MadeInFck/autonomous-robot/hardware/pico_carrier.kicad_sch

## KiCad design hardware/pico_carrier.kicad_sch (2026-02-14)

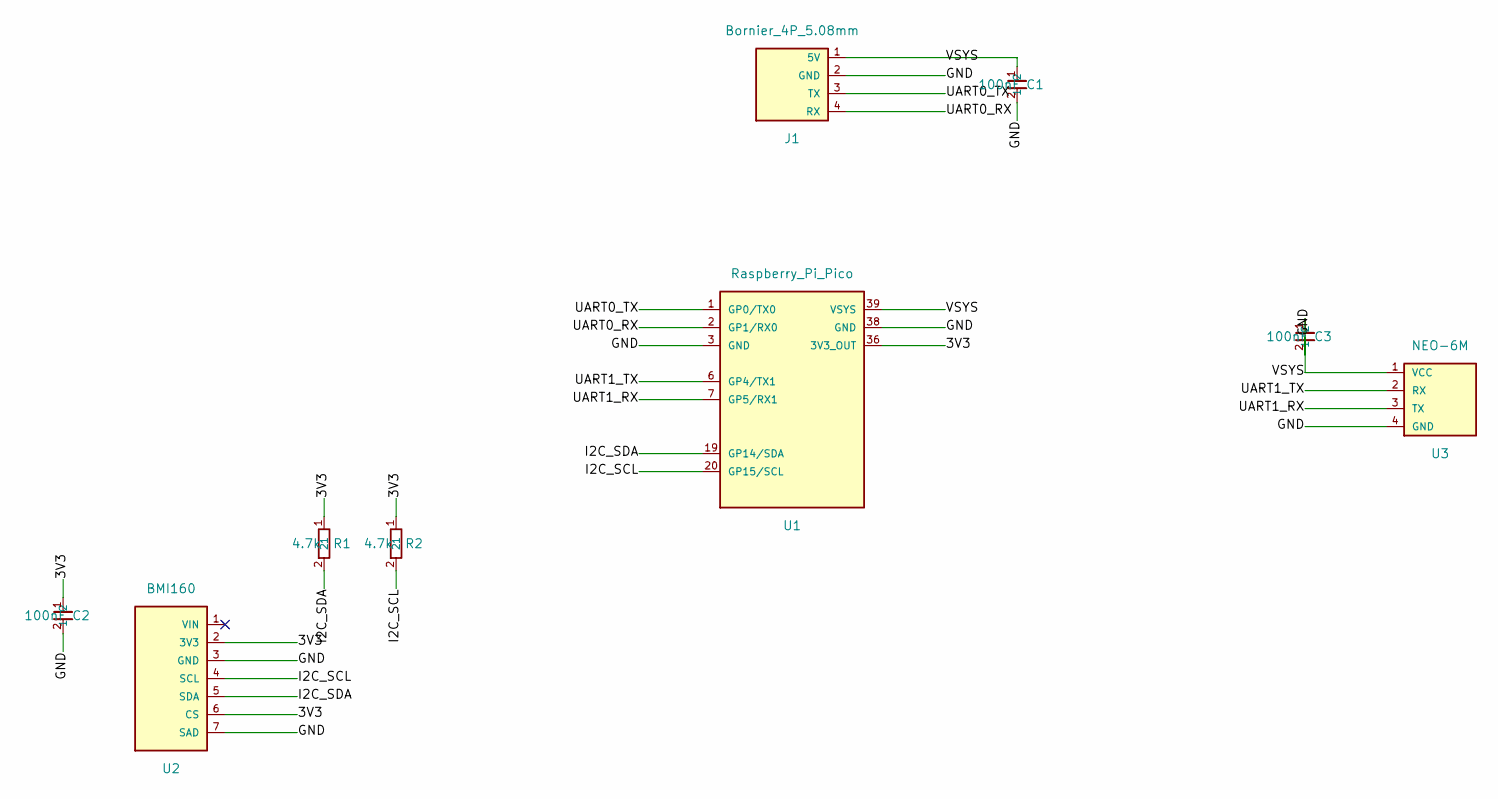
[picture p1: schematic pico_carrier.kicad_sch]

Parts:
C1, C2, C3: 100nF; C_0805_2012Metric
J1: Bornier_4P_5.08mm; TerminalBlock_bornier-4_P5.08mm
R1, R2: 4.7k; R_0805_2012Metric
U1: Raspberry_Pi_Pico; PinHeader_2x20_P2.54mm_Vertical
U2: BMI160; PinHeader_1x07_P2.54mm_Vertical
U3: NEO-6M; PinHeader_1x04_P2.54mm_Vertical

Connections:
3V3: C2.1, R1.1, R2.1, U1.36 (3V3_OUT), U2.2 (3V3), U2.6 (CS)
GND: C1.1, C1.2, C2.2, C3.1, C3.2, J1.1 (5V), J1.2 (GND), U1.3 (GND), U1.38 (GND), U1.39 (VSYS), U2.3 (GND), U2.7 (SAD), U3.1 (VCC), U3.4 (GND)
I2C_SCL: R2.2, U1.20 (GP15/SCL), U2.4 (SCL)
I2C_SDA: R1.2, U1.19 (GP14/SDA), U2.5 (SDA)
UART0_RX: J1.4 (RX), U1.2 (GP1/RX0)
UART0_TX: J1.3 (TX), U1.1 (GP0/TX0)
UART1_RX: U1.7 (GP5/RX1), U3.3 (TX)
UART1_TX: U1.6 (GP4/TX1), U3.2 (RX)
