MadeInFck/autonomous-robot/pi5/tests/test_uart_receiver.py

"""
Tests for FrameReader (state machine) and UART decoding
"""

import sys
import os
import pytest

sys.path.insert(0, os.path.join(os.path.dirname(__file__), '..', 'sensors'))
sys.path.insert(0, os.path.join(os.path.dirname(__file__), '..', '..', 'pico', 'lib'))

import json

from uart_receiver import (
    FrameReader, parse_payload, calc_crc8, STX, ETX, PAYLOAD_LEN,
    ImuCalibrationLatch, frame_to_sensor_data,
)
from protocole import (
    build_frame, FLAG_IMU_BNO085, FLAG_IMU_HEADING, convert_angle_to_centideg,
    convert_accuracy_to_raw, convert_course_to_raw,
)


def make_valid_frame(**kwargs):
    """Helper: build a valid frame with default values"""
    defaults = dict(
        seq=1, acc_x=0, acc_y=0, acc_z=981,
        gyr_x=0, gyr_y=0, gyr_z=0,
        latitude=48856600, longitude=2352200,
        altitude=352, vitesse=0, cap=0,
        satellites=8, fix_quality=1
    )
    defaults.update(kwargs)
    return build_frame(**defaults)


# ===== FrameReader: valid frames =====

class TestFrameReaderValid:
    def test_single_valid_frame(self):
        reader = FrameReader()
        frame = make_valid_frame()
        reader.feed(frame)

        result = reader.get_frame()
        assert result is not None
        assert result['crc_ok'] is True
        assert result['seq'] == 1

    def test_multiple_frames(self):
        reader = FrameReader()
        for i in range(5):
            frame = make_valid_frame(seq=i)
            reader.feed(frame)

        for i in range(5):
            result = reader.get_frame()
            assert result is not None
            assert result['seq'] == i

        assert reader.get_frame() is None

    def test_frame_data_decoded(self):
        reader = FrameReader()
        frame = make_valid_frame(
            seq=42, acc_x=100, acc_y=-200, acc_z=981,
            satellites=12, fix_quality=2
        )
        reader.feed(frame)

        result = reader.get_frame()
        assert result['seq'] == 42
        assert abs(result['acc_x'] - 0.1) < 0.001
        assert abs(result['acc_y'] - (-0.2)) < 0.001
        assert result['satellites'] == 12
        assert result['fix_quality'] == 2

    def test_byte_by_byte(self):
        """Byte-by-byte feeding (as in serial reception)"""
        reader = FrameReader()
        frame = make_valid_frame()

        for byte in frame:
            reader.feed(bytes([byte]))

        result = reader.get_frame()
        assert result is not None
        assert result['crc_ok'] is True


# ===== FrameReader: errors =====

class TestFrameReaderErrors:
    def test_bad_crc(self):
        reader = FrameReader()
        frame = bytearray(make_valid_frame())
        frame[-2] ^= 0xFF  # Corrupt the CRC
        reader.feed(bytes(frame))

        assert reader.get_frame() is None
        error = reader.get_error()
        assert error is not None
        assert "CRC" in error

    def test_missing_etx(self):
        reader = FrameReader()
        frame = bytearray(make_valid_frame())
        frame[-1] = 0x00  # Replace ETX with something else
        reader.feed(bytes(frame))

        assert reader.get_frame() is None
        error = reader.get_error()
        assert error is not None
        assert "ETX" in error

    def test_garbage_before_frame(self):
        """Random bytes before STX should be ignored"""
        reader = FrameReader()
        garbage = bytes([0x55, 0xAA, 0xFF, 0x00, 0x42])
        frame = make_valid_frame(seq=99)
        reader.feed(garbage + frame)

        result = reader.get_frame()
        assert result is not None
        assert result['seq'] == 99

    def test_garbage_between_frames(self):
        """Garbage between two valid frames"""
        reader = FrameReader()
        f1 = make_valid_frame(seq=1)
        f2 = make_valid_frame(seq=2)
        garbage = bytes([0xFF, 0xAA, 0x55])

        reader.feed(f1 + garbage + f2)

        r1 = reader.get_frame()
        assert r1 is not None
        assert r1['seq'] == 1

        r2 = reader.get_frame()
        assert r2 is not None
        assert r2['seq'] == 2

    def test_partial_frame_then_complete(self):
        """Partial frame followed by a complete frame"""
        reader = FrameReader()
        frame = make_valid_frame(seq=77)

        # Send the first half
        reader.feed(frame[:17])
        assert reader.get_frame() is None

        # Send the rest
        reader.feed(frame[17:])
        result = reader.get_frame()
        assert result is not None
        assert result['seq'] == 77

    def test_zero_length(self):
        """Length 0 must be rejected"""
        reader = FrameReader()
        reader.feed(bytes([STX, 0x00]))
        error = reader.get_error()
        assert error is not None
        assert "invalide" in error.lower()

    def test_corrupted_payload(self):
        """Corrupted payload but CRC preserved = CRC mismatch"""
        reader = FrameReader()
        frame = bytearray(make_valid_frame())
        frame[10] ^= 0xFF  # Corrupt a payload byte
        reader.feed(bytes(frame))

        assert reader.get_frame() is None
        assert reader.get_error() is not None


# ===== parse_payload =====

class TestParsePayload:
    def test_payload_size(self):
        """The payload must be exactly 30 bytes"""
        import struct
        payload = struct.pack('<HhhhhhhllhHHBB',
                              0, 0, 0, 0, 0, 0, 0, 0, 0, 0, 0, 0, 0, 0)
        assert len(payload) == PAYLOAD_LEN

    def test_speed_conversion(self):
        """Speed cm/s -> m/s and km/h"""
        import struct
        # 500 cm/s = 5.0 m/s = 18.0 km/h
        payload = struct.pack('<HhhhhhhllhHHBB',
                              0, 0, 0, 0, 0, 0, 0, 0, 0, 0, 500, 0, 0, 0)
        data = parse_payload(payload)
        assert abs(data['vitesse_ms'] - 5.0) < 0.01
        assert abs(data['vitesse_kmh'] - 18.0) < 0.01

    def test_heading_conversion(self):
        """Heading 0.01deg -> deg"""
        import struct
        # 27050 = 270.50 deg
        payload = struct.pack('<HhhhhhhllhHHBB',
                              0, 0, 0, 0, 0, 0, 0, 0, 0, 0, 0, 27050, 0, 0)
        data = parse_payload(payload)
        assert abs(data['cap'] - 270.5) < 0.01


# ===== Sequence checking =====

class TestSequenceCheck:
    def test_sequence_wrap_around(self):
        """Sequence must wrap from 65535 to 0"""
        frame_max = make_valid_frame(seq=65535)
        frame_zero = make_valid_frame(seq=0)

        reader = FrameReader()
        reader.feed(frame_max)
        reader.feed(frame_zero)

        r1 = reader.get_frame()
        r2 = reader.get_frame()
        assert r1['seq'] == 65535
        assert r2['seq'] == 0


# ===== Resync after line noise =====

class TestResync:
    def test_bogus_length_does_not_swallow_next_frame(self):
        """An STX in the noise followed by a large LEN used to eat 255 bytes."""
        reader = FrameReader()
        reader.feed(bytes([STX, 0xFF]) + make_valid_frame(seq=5))
        result = reader.get_frame()
        assert result is not None and result['seq'] == 5


# ===== BNO085 frames =====

def make_bno_frame(pitch=0.0, roll=0.0, accuracy=5.0, yaw=0.0, fix=1,
                   course=0.0, live=True):
    return make_valid_frame(
        acc_x=convert_angle_to_centideg(pitch),
        acc_y=convert_angle_to_centideg(roll),
        acc_z=0, gyr_x=convert_course_to_raw(course), gyr_y=0,
        gyr_z=convert_accuracy_to_raw(accuracy),
        cap=int(yaw * 100),
        fix_quality=fix | FLAG_IMU_BNO085 | (FLAG_IMU_HEADING if live else 0),
    )


def decode(frame_bytes):
    reader = FrameReader()
    reader.feed(frame_bytes)
    return reader.get_frame()


@pytest.fixture
def latch(tmp_path):
    return ImuCalibrationLatch(path=str(tmp_path / 'cal.json'))


class TestBno085Decoding:
    @pytest.mark.parametrize('pitch, roll', [
        (0.0, 0.0), (12.34, -5.5), (-45.0, 170.0), (89.9, -179.99),
    ])
    def test_orientation_full_range(self, pitch, roll, latch):
        """Pitch/roll beyond +/-32.7 deg used to overflow the int16 field."""
        data = frame_to_sensor_data(decode(make_bno_frame(pitch, roll)), latch)
        assert data.imu_type == 'BNO085'
        assert abs(data.pitch - pitch) < 0.011
        assert abs(data.roll - roll) < 0.011

    def test_orientation_clamped_not_wrapped(self):
        assert convert_angle_to_centideg(400.0) == 18000
        assert convert_angle_to_centideg(-400.0) == -18000

    def test_accuracy_and_fields(self, latch):
        data = frame_to_sensor_data(decode(make_bno_frame(accuracy=7.5, yaw=271.25)), latch)
        assert abs(data.heading_accuracy_deg - 7.5) < 0.01
        assert abs(data.heading - 271.25) < 0.01
        assert data.imu_calibrated is True
        # BMI160 fields carry nothing with a BNO085
        assert data.acc_x == data.acc_y == data.gyr_z == 0.0

    def test_accuracy_capped(self):
        assert convert_accuracy_to_raw(500.0) == 1800

    def test_bmi160_frame_keeps_raw_imu(self, latch):
        frame = decode(make_valid_frame(acc_x=120, acc_z=981, gyr_z=-35))
        data = frame_to_sensor_data(frame, latch)
        assert data.imu_type == 'BMI160'
        assert abs(data.acc_x - 0.12) < 1e-9
        assert abs(data.gyr_z + 3.5) < 1e-9
        assert data.imu_calibrated is False
        assert data.pitch == data.roll == 0.0


class TestHeading:
    def test_gps_course_travels_beside_the_compass(self, latch):
        data = frame_to_sensor_data(decode(make_bno_frame(yaw=95.0, course=12.3)), latch)
        assert data.heading == pytest.approx(95.0)
        assert data.course == pytest.approx(12.3)
        assert data.imu_heading_valid is True

    def test_mounting_offset_applied_once_and_wrapped(self, latch):
        frame = decode(make_bno_frame(yaw=350.0))
        assert frame_to_sensor_data(frame, latch, 20.0).heading == pytest.approx(10.0)
        assert frame_to_sensor_data(frame, latch, -20.0).heading == pytest.approx(330.0)

    def test_silent_compass_falls_back_to_gps_course(self, latch, tmp_path):
        """No BNO085 report: the heading is the GPS course, never trusted as a
        compass, and a saved calibration is not forgotten for so little."""
        assert latch.update(5.0) is True
        frame = decode(make_bno_frame(yaw=95.0, course=12.3, accuracy=180.0, live=False))
        data = frame_to_sensor_data(frame, latch, heading_offset_deg=30.0)
        assert data.heading == pytest.approx(12.3)
        assert data.imu_calibrated is False and data.imu_heading_valid is False
        assert json.loads((tmp_path / 'cal.json').read_text())['calibrated'] is True

    def test_bmi160_course_is_the_cap(self, latch):
        data = frame_to_sensor_data(decode(make_valid_frame(cap=4520)), latch, 30.0)
        assert data.heading == data.course == pytest.approx(45.2)

    def test_course_encoding(self):
        assert convert_course_to_raw(359.95) == 3599
        assert convert_course_to_raw(360.0) == 0


class TestImuCalibrationLatch:
    def test_good_accuracy_calibrates_and_persists(self, latch, tmp_path):
        assert latch.update(25.0) is False
        assert latch.update(8.0) is True
        assert json.loads((tmp_path / 'cal.json').read_text())['calibrated'] is True

    def test_persisted_state_trusted_after_reboot(self, tmp_path):
        path = str(tmp_path / 'cal.json')
        ImuCalibrationLatch(path).update(5.0)
        rebooted = ImuCalibrationLatch(path)
        assert rebooted.update(20.0) is True    # still converging, DCD known

    def test_strong_disturbance_forgets_calibration(self, tmp_path):
        path = str(tmp_path / 'cal.json')
        ImuCalibrationLatch(path).update(5.0)
        rebooted = ImuCalibrationLatch(path)
        rebooted.update(45.0)
        assert rebooted.update(20.0) is False
        assert json.loads((tmp_path / 'cal.json').read_text())['calibrated'] is False

    def test_missing_or_corrupt_file_means_uncalibrated(self, tmp_path):
        bad = tmp_path / 'cal.json'
        bad.write_text('{not json')
        assert ImuCalibrationLatch(str(bad)).update(20.0) is False
