MadeInFck/autonomous-robot/(commit log)

2026-02-07 functional robot with gps and imu sensors
    [robot_config.yaml]
2026-02-14 GPS feature functional
    [pico_carrier.kicad_sch]
2026-02-14 Add autonomous patrol with RPLidar C1 obstacle avoidance
    Integrate RPLidar C1 for obstacle detection (DBSCAN clustering, temporal
    tracking, occupancy grid) and GPS waypoint navigation for autonomous
    garden patrol. Web interface extended with lidar canvas, waypoint
    management panel and patrol controls.
    [robot_config.yaml]
2026-02-14 Remove obsolete test scripts (gpstest, pico/test_uart)
2026-02-14 Fix mobile layout: safe-area padding, smaller lidar canvas, tighter spacing
    [web_server.py]
2026-02-14 Fix touch scrolling on iPhone: restrict touch-action:none to joysticks only
    [web_server.py]
2026-02-14 Show error message when recording waypoint without GPS fix
    [web_server.py]
2026-02-14 Add web security: HTTP Basic Auth, TLS, XSS fix, input validation
    - HTTP Basic Auth with scrypt-hashed password (werkzeug)
    - TLS/HTTPS support with self-signed certificate (auto-fallback to HTTP)
    - Fix XSS in waypoint list (innerHTML replaced by DOM API)
    - Clamp movement inputs (vx/vy/omega to [-1,1], speed to [0,100])
    - Sanitize error messages (no exception leak)
    - Add MAX_CONTENT_LENGTH (16KB) against oversized requests
    - Add --no-auth CLI flag for development
    - Config: auth + tls sections in robot_config.yaml
    - SSL certs excluded from git via .gitignore
    [robot_config.yaml]
2026-02-14 Fix TLS and patrol file path resolution
    Paths in config (config/ssl/cert.pem, config/patrol_route.json) are
    relative to the project root, but cwd on Pi5 is pi5/. Use absolute
    paths based on PROJECT_ROOT instead of relative paths.
    - Add PROJECT_ROOT constant (parent of pi5/)
    - Fix load_web_config: resolve TLS paths from project root (was doubled: config/config/ssl/)
    - Fix patrol file save: pass absolute path to WebServer instead of hardcoded relative path
    [main.py, web_server.py]
2026-02-14 Update README: add security docs, new API endpoints, remove obsolete refs
    - Add security section (auth + TLS with certificate generation instructions)
    - Remove auth details (username/hash) to avoid committing credentials
    - Add lidar/patrol API endpoints to the API table
    - Add new CLI options (--no-lidar, --lidar-port, --no-auth)
    - Remove test_uart.py references (file deleted)
    - Update project structure (config/ssl/, patrol_route.json)
2026-02-14 Move auth+TLS secrets to config/secrets.yaml (ignored by git)
    - Create config/secrets.yaml for auth credentials and TLS config
    - Create config/secrets.yaml.example as template
    - Remove auth/tls sections from robot_config.yaml
    - Update main.py to load from secrets.yaml
    - Add config/secrets.yaml to .gitignore
    [robot_config.yaml]
2026-02-20 Translate codebase to English, add non-commercial license
    Translate all comments, docstrings, and documentation to English while
    keeping user-facing strings (print, HTML, API responses) in French.
    Add README_fr.md as French copy, add custom non-commercial LICENSE file.
    [robot_config.yaml]
2026-02-20 Improve web UI: speed control, shutdown button, iOS TODO
    - Set initial speed to 30%, min to 10%, step to 5%
    - Add proper shutdown button (POST /api/shutdown) with confirmation dialog
    - Add iOS app as future TODO in both READMEs
2026-02-21 Add WiFi access point scripts (NetworkManager)
    Setup Pi 5 as RobotPatroller hotspot via nmcli with switch scripts
    to toggle between AP mode (patrol) and client mode (rsync/updates).
2026-02-21 Fix autonomous navigation: arc PID, GPS debug, waypoint counter
    pilot.py:
    - Remove TURNING state (gyro BMI160 gyr_z always 0, hardware issue)
    - Replace stop-rotate-go with pure arc navigation (PID omega while moving)
    - Remove speed threshold gate (_MIN_SPEED_FOR_HEADING): NEO-6M does not
    report speed reliably, was blocking all heading correction
    - Add debug telemetry: dbg_bearing, dbg_avg_heading, dbg_heading_error,
    dbg_omega, dbg_speed exposed via get_status() for web UI
    patrol_manager.py:
    - Monotonic _wp_counter for stable WP labels across deletions
    - Reset counter to 0 when all waypoints deleted
    - Waypoint radius 3m → 4m (reduce false triggers)
    - Persist wp_counter in patrol JSON f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
    [web_server.py]
2026-02-22 Add BNO085 driver, BMI160 diagnostic, fix GPS heading filter
    - pico/lib/bno085.py: new BNO085 9-DOF driver (SHTP/I2C, Rotation Vector,
    yaw/pitch/roll from onboard fusion — replaces GPS COG for heading)
    - pico/diag_bmi160.py: diagnostic script for Thonny (chip ID, PMU status,
    gyro self-test, 10 raw samples — detects clone chips with dead gyro)
    - pico/lib/bmi160_raw.py: init rewrite with soft reset, PMU polling,
    fast_start fallback for stubborn clone chips
    - pi5/navigation/pilot.py: filter GPS heading buffer to ignore COG=0
    (GPS sends 0.0 at rest); guard against empty buffer to prevent circling
    - README.md / README_fr.md: document both IMU options (BMI160 option A,
    BNO085 option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
    [diag_bmi160.py]
2026-02-22 Integrate IMX500 AI Camera with EfficientDet Lite0 detection
    - pi5/camera/ai_camera.py: background thread reading IMX500 inference
    metadata, 80-class COCO labels, 5s cooldown per alert label, history
    of last 20 detections (person + animals trigger alerts)
    - pi5/main.py: AiCamera init, start/stop lifecycle, --no-camera and
    --camera-conf flags, pass camera to WebServer
    - pi5/telemetry/web_server.py: GET /api/detections endpoint, camera_ok
    field in /api/status, "Caméra IA" UI panel with 10-entry history,
    toast notification on new alert detections (2s poll interval)
2026-02-22 Camera: persistent alert UI, remove bird, add MJPEG stream modal
    - Remove 'bird' from ALERT_LABELS (too many outdoor false positives)
    - Add frame capture in _loop() via capture_array() + JPEG encoding (cv2)
    - Add get_latest_jpeg() and generate_stream() MJPEG generator
    - Add GET /api/stream endpoint (multipart/x-mixed-replace MJPEG)
    - Detection panel turns red while person/animal detected in last 15s
    - "Voir le flux" button opens stream in a fullscreen modal overlay
    - Modal closes on backdrop click or X button, stops MJPEG connection
    [ai_camera.py, web_server.py]
2026-02-22 Fix camera stream orientation and button layout
    - Remove cv2.flip() — orientation handled client-side via CSS
    - Add transform: rotate(180deg) on stream <img> in modal
    - Move "Voir le flux" button to its own full-width line below status
    [ai_camera.py, web_server.py]
2026-02-22 Raise detection threshold to 50%, remove stream flip, update READMEs
    - ai_camera.py: CONF_THRESHOLD 0.35 → 0.50 (only show detections ≥ 50%)
    - main.py: --camera-conf default updated to 0.50
    - web_server.py: remove CSS rotate(180deg) on stream img
    - README / README_fr: document AI camera (architecture, features, project
    structure, startup flags, /api/detections + /api/stream endpoints);
    mark AI camera TODO as done
    [ai_camera.py, main.py, web_server.py]
2026-02-22 Add camera pause/resume toggle
    - AiCamera: pause() clears history/jpeg and skips encoding+detection
    while still draining picam2 buffer; resume() restores full operation
    - POST /api/camera/toggle endpoint
    - /api/detections: adds 'paused' field
    - UI: ⏸ Couper / ▶ Allumer button inline with camera status; modal closes
    on pause; detection list shows "Caméra en pause" state
    [ai_camera.py, web_server.py]
2026-02-22 Fix camera pause: stop picam2 for real power saving
    Previously pause() kept the picam2 pipeline running (only skipped
    JPEG encoding), saving ~nothing. Now pause() calls picam2.stop() to
    fully idle the IMX500 sensor+NNA (~1.5-2W saved). The EfficientDet
    model stays loaded on-chip so resume()/picam2.start() is fast (<1s).
    _loop() sleeps 100ms while paused instead of spinning on capture_array.
    [ai_camera.py]
2026-02-22 Disable stream button when camera is paused
2026-02-22 Fix pause/resume + add bounding boxes on stream
    - pause()/resume(): revert to soft pause (no picam2.stop/start) — hard
    stop broke IMX500 inference pipeline on restart; picam2 keeps running,
    encoding+detection skipped, buffer drains silently
    - _parse_raw(): also returns raw box coords (y1,x1,y2,x2) per detection
    - _loop(): draw labeled bounding boxes on frame before JPEG encoding;
    uses imx500.convert_inference_coords() with fallback scaling (320×320);
    alert labels (person/animal) in orange, others in green
    - Replace _CV2_OK flag with direct 'cv2 is not None' check for correct
    type narrowing (Pylance/Pyright compatibility)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
    [ai_camera.py]
2026-02-22 Pause: reduce FPS to 1 instead of stopping pipeline
    picam2.stop()/start() breaks IMX500 inference: the model is uploaded
    to the chip's SRAM at each start() via the IPA firmware, taking 10-30s,
    and get_outputs() returns None until the upload completes. The pipeline
    must stay alive for instant resume.
    Reduce FrameRate to 1fps on pause (vs 15fps active) — ~93% reduction
    in NNA inference cycles with immediate full-rate resume.
2026-02-22 Camera: real stop/start pause with loading UI
    - pause() now calls picam2.stop() for true power saving (~1.5-2 W)
    - resume() calls picam2.start() + sets _resuming=True flag
    - _loop() clears _resuming on first valid inference output
    - is_starting() exposes the warm-up state (10-30 s model upload)
    - /api/detections exposes 'starting' field
    - UI: orange pulsing dot + "Démarrage (10-30 s)" message + disabled
    toggle/stream buttons during model reload
    - Fix _parse_raw to include box in returned tuple (was causing ValueError
    when unpacking in _loop)
2026-02-22 Add restart button alongside shutdown in web UI
    - New POST /api/restart endpoint (sudo reboot, 1s delay)
    - Orange restart button next to the red shutdown button
    - Toast: "Reconnectez-vous dans ~30s"
2026-03-06 Integrate BNO085 into pico/main.py (auto-detect)
    Auto-detects IMU on I2C1: BNO085 at 0x4A (preferred) or BMI160 at
    0x68 (fallback). With BNO085, drains buffered fusion reports each loop
    and uses imu.yaw as the heading field (replaces GPS COG); acc and gyr
    fields are set to 0. Debug output shows yaw/pitch/roll and calibration
    status. BMI160 path unchanged.
2026-03-06 BNO085: fix EIO on RP2040 — longer boot delay, 100 kHz I2C
    - _init: boot delay 0.3s → 0.8s (chip needs 600-800ms)
    - _init: drain 10 → 15 packets, abort early if write already failed
    - __main__ test: 400kHz → 100kHz (avoids clock-stretching timeouts)
    - main.py: IMU_FREQ 400kHz → 100kHz for the same reason
2026-03-06 BNO085: fix silent read — two-phase I2C + multi-packet drain
    _read_packet: single readfrom(64) over-read caused RP2040 to receive
    garbage when packet < 64 bytes, corrupting subsequent reads. Replace
    with proper two-phase read (4-byte header → determine length → full
    packet), matching the Adafruit BNO08x reference implementation.
    update(): read up to 8 packets per call instead of 1 so the loop
    doesn't fall behind when main loop runs slower than rate_hz.
2026-03-06 BNO085: fix silent read — two-phase I2C + multi-packet drain
    The BNO085 prepends a 5-byte Timestamp Rebase (0xFB + 4-byte timestamp)
    before each Rotation Vector report in the same SHTP payload. update()
    was checking payload[0] == 0x05, but payload[0] == 0xFB, so every
    valid packet was silently discarded.
    Fix: skip the 5-byte prefix when payload[0] == 0xFB before checking
    for the Rotation Vector report ID.
2026-03-06 BNO085: expose calibration status in web UI
    Encode heading_accuracy_deg*10 into the gyr_z wire field (gyr_x/y=0
    serves as BNO085 sentinel). Pi5 uart_receiver detects the IMU type
    and populates imu_type / heading_accuracy_deg / imu_calibrated on
    SensorData. Web UI adapts: IMU dot in status bar + BNO085 panel
    replaces gyro XYZ when the chip is detected (orange until calibrated,
    green once accuracy < 15 deg).
2026-03-07 BNO085: calibration pipeline, heading fix, camera CPU optimisation
    - bno085.py: restore ME Cal Config (cmd 0x07) at init to enable dynamic
    mag/accel/gyro calibration; add save_calibration() (DCD save cmd 0x06);
    fix yaw convention ENU→compass (90-yaw_enu)%360 so heading increases
    when turning right (N=0°, E=90°); lower is_calibrated() threshold to 10°
    - main.py: restore cal_saved flag + auto-save DCD once calibrated
    - uart_receiver.py: align imu_calibrated threshold to 10°
    - ai_camera.py: start paused by default; skip frame capture when no MJPEG
    client connected (_stream_clients counter); 60 s timeout on _resuming;
    reduce FrameRate 15→10 fps
    - web_server.py: Flask threaded=T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
2026-03-07 pilot: use BNO085 heading directly when calibrated
    GPS COG requires smoothing buffer and is undefined at rest (filtered by
    > 0.1° guard). BNO085 heading is stable, instant and valid at 0° (North)
    — bypasses the buffer entirely. Heading validity check now also accepts
    imu_calibrated so correction works from the first packet even before the
    robot moves.
2026-03-07 camera: reduce framerate to 2 fps when no stream client
    capture_metadata() blocks on each frame — sleeping after does nothing.
    Only set_controls(FrameRate) actually slows the libcamera pipeline and
    cuts CPU. Switch to 2 fps in detection-only mode, 10 fps when streaming.
    Transition fires once on _stream_clients change to avoid redundant calls.
2026-03-07 camera: raise stream fps to 15 (modal open = robot stopped)
    When the video modal is open the user cannot drive the robot, so stream
    CPU saturation has no impact on navigation. 15 fps gives smoother video.
    Detection-only mode stays at 2 fps for minimal patrol CPU impact.
2026-03-07 camera: run picamera2 pipeline in a subprocess to eliminate GIL contention
    capture_metadata() is a blocking C call that can hold the GIL even at
    2 fps, stalling Flask and motor threads for up to 500 ms per frame.
    Moving the entire Picamera2 pipeline into a dedicated OS process gives
    it its own GIL — zero impact on navigation regardless of framerate.
    AiCamera public API is unchanged. A lightweight drain thread reads
    detection results and JPEG frames from a multiprocessing.Queue and
    updates local state. spawn context avoids fork+thread hazards.
    Framerates: 2 fps (detection only) / 15 fps (streaming, robot stopped).
2026-03-07 camera: start active by default, raise detection fps to 4
    Now that the camera runs in a subprocess (no GIL impact), there is no
    reason to start paused. picam2 starts immediately in the subprocess;
    AiCamera.start() sets _resuming=True so the UI shows the loading state
    until the first inference output arrives. Detection-only framerate raised
    2→4 fps for better responsiveness during patrol. UI button initialises
    to "Démarrage…" instead of "Allumer".
2026-03-07 BNO085: fix DCD save reliability + persist calibration state across reboots
    bno085.py: save_calibration() now waits for Command Response (0xF1) from
    the sensor confirming the flash write is complete. Previously the command
    was fire-and-forget — if the robot powered off before the write finished
    the DCD was silently corrupted.
    uart_receiver.py: persist imu_calibrated state to
    ~/.config/robot/imu_cal_state.json after first successful calibration.
    On reboot the UI shows green immediately (DCD loaded) while the sensor
    reconverges. State is cleared if accuracy degrades above 30°.
2026-03-07 docs: update READMEs for BNO085 calibration and camera subprocess
    - Protocol: gyr_z with BNO085 encodes heading_accuracy_deg×10 (not 0)
    - ai_camera.py: described as dedicated subprocess, not background thread
    - BNO085 section: calibration procedure, DCD persistence, heading convention
2026-03-08 feat: transmit BNO085 pitch/roll via UART and display in telemetry
    Encodes imu.pitch and imu.roll in the acc_x/acc_y frame fields
    (millidegrees, same ×1000 scaling as mg) for BNO085 frames.
    Pi5 extracts them into dedicated SensorData.pitch/roll fields;
    web UI uses sensor-fusion values directly instead of deriving
    pitch/roll from a zeroed accelerometer vector.
    Also removes unused diag_bmi160.py.
2026-04-06 fix: GPS baud rate 115200 + add heading_offset_deg to pilot
    GPS module was reconfigured to 115200 baud (was 9600), causing
    zero satellite data. Also adds a configurable heading_offset_deg
    (+45°) to compensate for BNO085 systematic magnetic bias in the
    robot's environment.
2026-07-31 security: harden web server against pentest findings
    Closes the weaknesses found while pentesting the running server:
    - Auth throttle: 10 failed attempts per IP / 60 s -> 429, refused *before*
    the KDF runs (closes credential brute-force and the scrypt CPU DoS).
    Only failures carrying credentials are counted, so an authenticated
    client (manual piloting, ~13 req/s via the auth cache) is never
    throttled, and a credential-less first hit does not count either.
    - Uniform auth timing: the KDF now runs even for an unknown username,
    removing the 10 ms / 60 ms oracle that revealed the valid one.
    - /api/move rejects non-finite input: NaN/inf used to survive min/max and
    reach the mixer as a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
2026-08-01 feat: start the robot at boot via a systemd service
    Adds scripts/robot.service (template) and installs it from setup_pi5_env.sh
    as step 7, enabled by default.
    The unit is deliberately unsandboxed: NoNewPrivileges would break the web UI
    power buttons (restricted robot-power sudoers rule), PrivateDevices would cut
    GPIO and the serial ports, ProtectSystem=strict would block the IMU
    calibration state and the waypoint file. It runs as the unprivileged robot
    user instead, whose only elevation is shutdown/reboot.
    Stopping is safe: main.py already traps SIGTERM and runs RobotApp.shutdown(),
    so systemctl stop/restart cuts the motors, the pilot, lidar, UART and camera.
    TimeoutStopSec=30 leaves room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
2026-10-31 perf(motors): software PWM wakes on edges only, idle costs nothing
    The PWM thread used to tick every 0.5 ms step — 2000 wake-ups per second,
    each taking the GIL and the motor lock, even with the robot at rest. It now
    switches every running motor on at the start of the 10 ms cycle and sleeps
    straight to each distinct switch-off point: same waveform (a motor at
    n/20 duty is driven during the first n steps), a handful of wake-ups per
    cycle, and a blocked thread when all motors are stopped.
    Wheel commands are applied under a single lock, so the PWM thread never
    mixes a new speed on one wheel with the previous one on another, and
    identical repeated commands (watchdog stops, joystick heartbeat)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
2026-10-31 fix(lidar,pilot): avoidance steered into obstacles, scans leaked memory
    Pilot
    - Avoidance turned the wrong way. The free sector is a robot-frame
    direction in [0, 360) and was fed to the heading PID as-is: a free
    sector on the left (345deg) became a +345 error, i.e. a full right turn
    into the obstacle. It now goes through angle_diff() (-15deg, turn left).
    angle_diff is shared by the pilot and the avoider instead of duplicated.
    - New failsafe: with a lidar configured, a scan older than 1 s (USB lost,
    lidar dead) stops the motors like stale GPS does, instead of driving on
    the last frozen scan. Exposed as lidar_stale in /api/patrol/status.
    - Each scan goes through the detector once;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
2026-10-31 fix(uart): BNO085 pitch/roll overflowed past 32.7deg; leaner UART path
    Protocol change — deploy Pico and Pi5 together. With a BNO085, pitch and
    roll travel in the int16 acc_x/acc_y fields. In millidegrees they wrapped
    beyond +/-32.767deg (a 40deg tilt read about -25deg, upside down was
    garbage); they are now sent in 0.01deg units, clamped to +/-180deg, and
    decoded by parse_payload() next to the rest of the protocol.
    Pi5 receiver
    - Blocking serial read (wakes per frame) instead of polling every 10 ms.
    - The frame reader rejects any length byte other than the fixed payload
    size: an STX in line noise used to swallow up to 255 bytes of good
    frames before resyncing.
    - BNO085 calibration pe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
2026-10-31 fix(web,camera): multi-viewer stream, frozen-GPS waypoints; leaner polling
    Web server
    - Pilot activity checked through pilot.is_active() instead of computing
    the full patrol status (haversine, rounding) on every manual command and
    every 100 ms watchdog tick.
    - Waypoint recording ignores UART frames older than 2 s: a dead Pico used
    to get its frozen position averaged and saved as a waypoint.
    - Duplicated waypoint saving, power commands and stop sequences factored
    into helpers; timing constants named; unused get_url() removed.
    Camera
    - Streaming is reference-counted: the first viewer closing the MJPEG
    stream sent stream_off and froze it for every other viewer.
    - Each frame is sent o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
2026-10-31 refactor(app): single source for defaults, cleaner startup; docs refresh
    main.py
    - Tuning defaults (speeds, PID gains, waypoint radius, camera threshold)
    live in the classes only; main maps the robot_config.yaml keys that are
    present onto keyword arguments instead of re-declaring every default
    (they had drifted: PatrolManager 4.0 vs 3.0 m, camera 0.35 vs 0.50).
    - One _init_component() helper replaces five copies of the
    try/log/fallback init block.
    - SIGINT/SIGTERM unwind run(), whose finally block shuts the hardware
    down — including when the signal lands while the camera model loads.
    - The 5 s main loop no longer pumps the lidar (it assembles scans itself)
    and logs heading/IMU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
2026-10-31 fix(motors): fail loudly when the GPIO lines are busy
    When gpiod could not claim the motor lines (held by another robot
    instance), the controller logged the error, fell back to simulation and
    the app reported "[Motors] OK": the UI showed motors connected while
    nothing could move. It now raises, so main.py logs "[Motors] Erreur" and
    starts without motors (and without the pilot, which needs them). Plain
    simulation is kept for machines without gpiod at all.
    Seen on the first deployment of the refactor: an old instance still held
    the GPIO, the camera, the UART and port 8085.
2026-10-31 feat(logs): colour log lines by severity
    Under systemd each line now carries an sd-daemon priority prefix, so
    journalctl shows warnings in yellow/orange and errors in red, and
    `journalctl -u robot -p warning` keeps only the problems. In a terminal
    the lines get ANSI colours (orange warnings, red errors); pipes and
    NO_COLOR stay plain. journald already timestamps entries, so the line
    drops its own timestamp there.
    A missing lidar or camera is now a warning: the robot runs without them.
    Motors and UART failures stay errors.
2026-10-31 fix(avoidance): fill sectors from every obstacle point, not the centroid
    Each obstacle used to land in the single 30deg sector of its centroid. A
    60 cm wall 60 cm ahead spans -27..+27deg but filled one sector, so the
    "free" neighbour at -15deg - still inside the wall - was chosen and the
    robot steered into it. A side wall whose centroid sat outside the
    corridor but whose points reached the front was not seen at all.
    Every point now marks its own sector. AvoidanceResult.to_dict() gives
    the UI a signed turn (negative = left) and drops the inf distance,
    which is not valid JSON.
2026-10-31 feat(lidar): show avoidance on the radar, switch the lidar from the UI
    Radar overlay: the watched corridor (green/orange/red by status), the
    avoidance reach as a dashed circle, obstacles within it (walls as
    segments, objects as circles), an arrow toward the chosen free sector
    or BLOQUE, and tap-to-zoom (6 / 3 / 1.5 m). The patrol status tells
    avoiding from blocked and shows the turn, distance and omega.
    Between patrols the pilot runs detection + avoidance on the latest scan
    for display only (obstacle_view), so the behaviour can be checked on
    the bench. A scan is still processed once, whoever asks first.
    A dashboard button stops and restarts the lidar (scanner start/stop is
    now restartable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
2026-11-07 docs: alimentation 12 V (batterie, fusible, buck, HW-249)
    Remplace l'ancienne mention d'une alimentation moteurs 5 V par le
    montage actuel : batterie 12 V, fusible 10 A, buck 5 V pour le Pi 5,
    HW-249 en 12 V via une diode, GND commun.
    Claude-Session: https://claude.ai/code/session_01SxgQMg3gw2LjwXABBfyZPV
2026-11-07 docs: moteurs sur 2 L298N en 12 V
    La carte 4 canaux HW-249 (L9110S) ne fonctionne pas en 12 V avec le
    Pi : ses pull-ups remontent les entrées vers le VCC et le 3,3 V n'est
    plus reconnu. Le README décrit maintenant les 2 L298N (cavaliers 5V-EN,
    ENA, ENB en place) et la correspondance GPIO -> IN1..IN4.
    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
2026-11-07 fix(ui): joystick commands starved by the debounce, driving was jerky
    sendCommand() cleared and re-armed a 50 ms timeout on every call, and the
    joystick calls it on every pointermove (~every 12 ms). While the thumb
    moved, nothing was sent at all; after 0.5 s the robot's watchdog cut the
    motors, then they restarted as soon as the finger paused. Worst at full
    speed, stick held against its edge.
    Commands are now throttled instead: at most one every 50 ms and one in
    flight, always carrying the latest stick state, with a 1 s timeout so a
    stalled request cannot hold back the next ones.
    Also:
    - the watchdog logs a warning when it stops a robot that was moving, so
    remaining jerks can be traced t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
2026-11-07 feat(motors): per-wheel speed trim, 1 % PWM resolution
    Motors rarely spin at the same rate for the same duty cycle: driving
    straight, the robot pivoted right (heading increasing). robot_config.yaml
    now takes a factor per wheel under `motors: trim:` (0.5-1.0, slowing the
    faster side so the correction still holds at full speed). Out-of-range
    or unknown entries are ignored with a warning; the applied trim is
    logged at startup. It applies to manual driving and patrol alike.
    PWM_STEPS goes from 20 to 100: at 5 % steps a 0.95 trim was rounded to
    nothing or to 0.92 depending on the speed. The loop still only wakes at
    switch-off points, so the finer grid costs nothing.
    Set to FL/RL 0.95 after test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
2026-11-08 fix(setup): install camera packages, disable WiFi power save
    A fresh install (dead SD card) showed what the setup was missing:
    - python3-opencv: the camera worker encodes stream frames with OpenCV only,
    so without it detection ran but the video stream stayed empty, silently.
    Now installed by setup_pi5_env.sh with imx500-all, python3-picamera2 and
    rsync, and AiCamera logs a warning when cv2 is absent.
    - WiFi power save, enabled by default with brcmfmac, made SSH sessions
    stall for seconds on the access point: setup_ap.sh now disables it.
    Also lowers the left wheels trim from 0.95 to 0.97 after road tests.
2026-11-09 fix(heading): pilot steered on the uncalibrated compass as GPS course
    The Pico sent only the BNO085 yaw in the heading field, so with an
    uncalibrated sensor the pilot buffered that yaw as GPS course over
    ground. The Pico now sends the GPS course separately (gyr_x, 0.1 deg)
    and flags a live BNO085 yaw with bit 6 of fix_quality (FLAG_IMU_HEADING);
    the pilot buffers gps.course until the compass is calibrated.
    The +45 deg navigation.heading_offset_deg compensated an uncalibrated
    sensor and was applied by the pilot only. It is replaced by
    imu.heading_offset_deg (default 0), applied once by the UART receiver,
    so the dashboard and the pilot see the same heading.
    - BNO085 watchdog: marks the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
2026-11-09 refactor(pico): load the BMI160 driver only when the sensor answers
    lib/bmi160_raw.py was imported unconditionally, so a Pico with only a
    BNO085 still had to carry it. It is now imported like bno085.py, only
    when its I2C address answers. With no IMU detected the Pico keeps
    sending GPS frames, flagged as an invalid IMU, instead of failing.
    The READMEs describe which driver to copy, and the frame layout now
    documents bit 6 and the GPS course in gyr_x.
